akito914/myServoAmp_InverterBoard/InverterBoard.kicad_pcb

## KiCad design InverterBoard.kicad_pcb (2020-04-21)

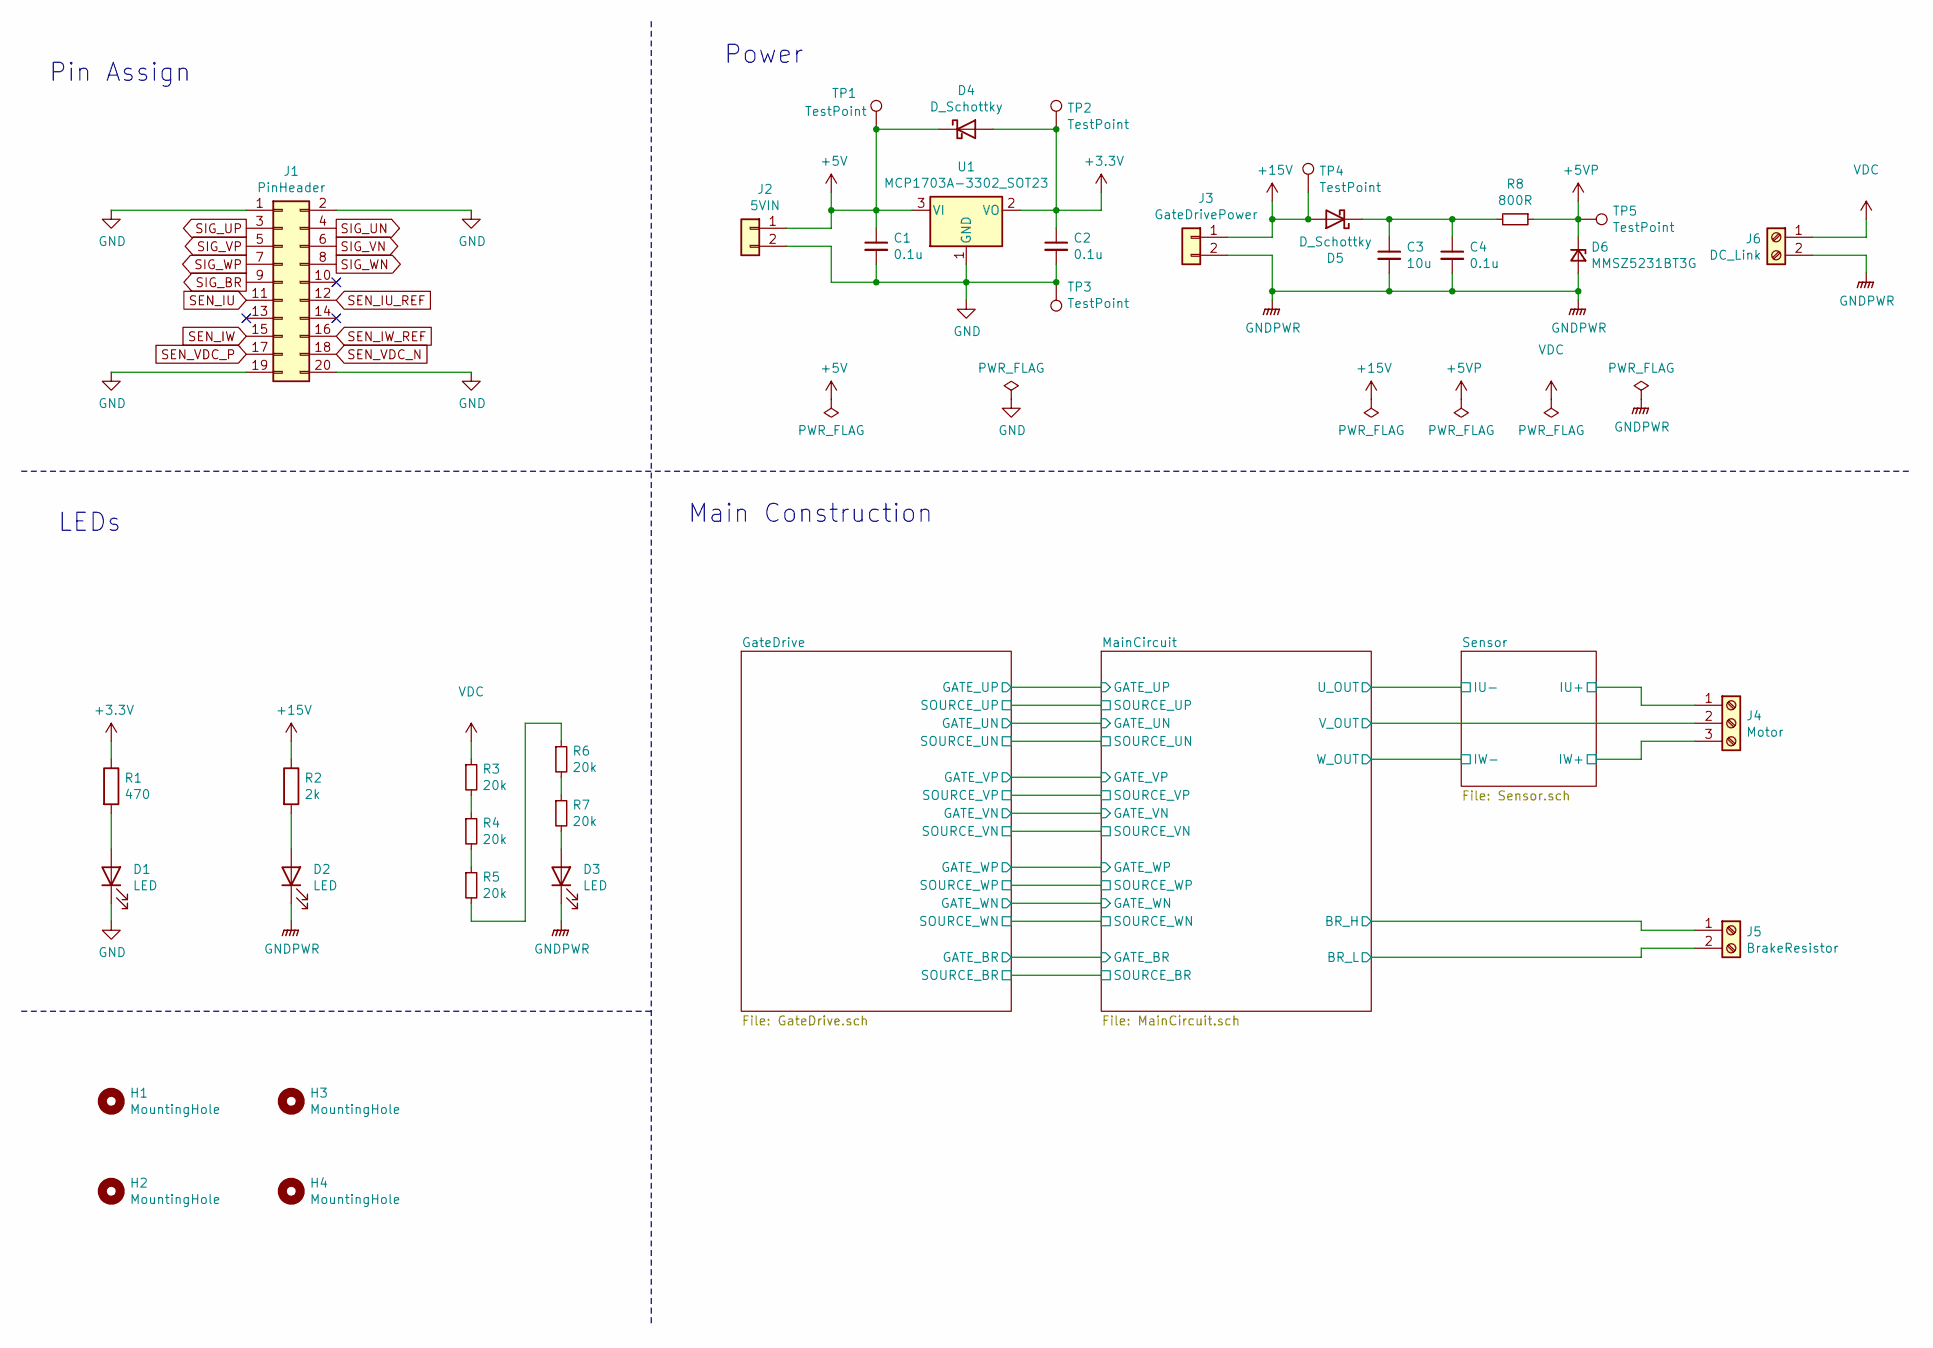
[picture p1: schematic InverterBoard.sch]

Parts:
C1, C2, C4: 0.1u; C_0603_1608Metric
C3: 10u; C_0805_2012Metric
D1, D2, D3: LED; LED_0603_1608Metric
D4, D5: D_Schottky; D_SOD-123
D6: MMSZ5231BT3G; D_SOD-123
H1, H2, H3, H4: MountingHole; MountingHole_3.2mm_M3
J1: PinHeader; IDC-Header_2x10_P2.54mm_Vertical
J2: 5VIN; JST_XH_S2B-XH-A-1_1x02_P2.50mm_Horizontal
J3: GateDrivePower; JST_XH_S2B-XH-A-1_1x02_P2.50mm_Horizontal
J4: Motor; JST_VH_B3PS-VH_1x03_P3.96mm_Horizontal
J5: BrakeResistor; JST_VH_B2PS-VH_1x02_P3.96mm_Horizontal
J6: DC_Link; JST_VH_B2PS-VH_1x02_P3.96mm_Horizontal
R1: 470; R_0603_1608Metric
R2: 2k; R_0603_1608Metric
R3, R4, R5, R6, R7: 20k; R_0603_1608Metric
R8: 800R; R_0603_1608Metric
TP1, TP2, TP3, TP4: TestPoint; TestPoint_Loop_D2.50mm_Drill1.0mm_LowProfile
TP5: TestPoint; TestPoint_Pad_D1.0mm
U1: MCP1703A-3302_SOT23; SOT-23

Connections:
+3V3: C2.1, D4.2 (A), R1.1, TP2.1, U1.2 (VO); also elsewhere on the board
+5V: C1.1, D4.1 (K), J2.1, TP1.1, U1.3 (VI)
+5VP: D6.1 (K), R8.1, TP5.1; also elsewhere on the board
+15V: D5.2 (A), J3.1, R2.1, TP4.1; also elsewhere on the board
/GateDrive/SOURCE_VP: J4.2; also elsewhere on the board
/MainCircuit/BR_L: J5.2; also elsewhere on the board
/Sensor/IU+: J4.1; also elsewhere on the board
/Sensor/IW+: J4.3; also elsewhere on the board
GND: C1.2, C2.2, D1.1 (K), J1.1, J1.2, J1.19, J1.20, J2.2, TP3.1, U1.1 (GND); also elsewhere on the board
GNDPWR: C3.2, C4.2, D2.1 (K), D3.1 (K), D6.2 (A), J3.2, J6.2; also elsewhere on the board
unnamed: C3.1, C4.1, D5.1 (K), R8.2
unnamed: D1.2 (A), R1.2
unnamed: D2.2 (A), R2.2
unnamed: D3.2 (A), R7.2
unnamed: R3.2, R4.1
unnamed: R4.2, R5.1
unnamed: R5.2, R6.1
unnamed: R6.2, R7.1
SEN_IU: J1.11; also elsewhere on the board
SEN_IU_REF: J1.12; also elsewhere on the board
SEN_IW: J1.15; also elsewhere on the board
SEN_IW_REF: J1.16; also elsewhere on the board
SEN_VDC_N: J1.18; also elsewhere on the board
SEN_VDC_P: J1.17; also elsewhere on the board
SIG_BR: J1.9; also elsewhere on the board
SIG_UN: J1.4; also elsewhere on the board
SIG_UP: J1.3; also elsewhere on the board
SIG_VN: J1.6; also elsewhere on the board
SIG_VP: J1.5; also elsewhere on the board
SIG_WN: J1.8; also elsewhere on the board
SIG_WP: J1.7; also elsewhere on the board
VDC: J5.1, J6.1, R3.1; also elsewhere on the board

Notes on the sheet:
Power
Main Construction
Pin Assign
LEDs

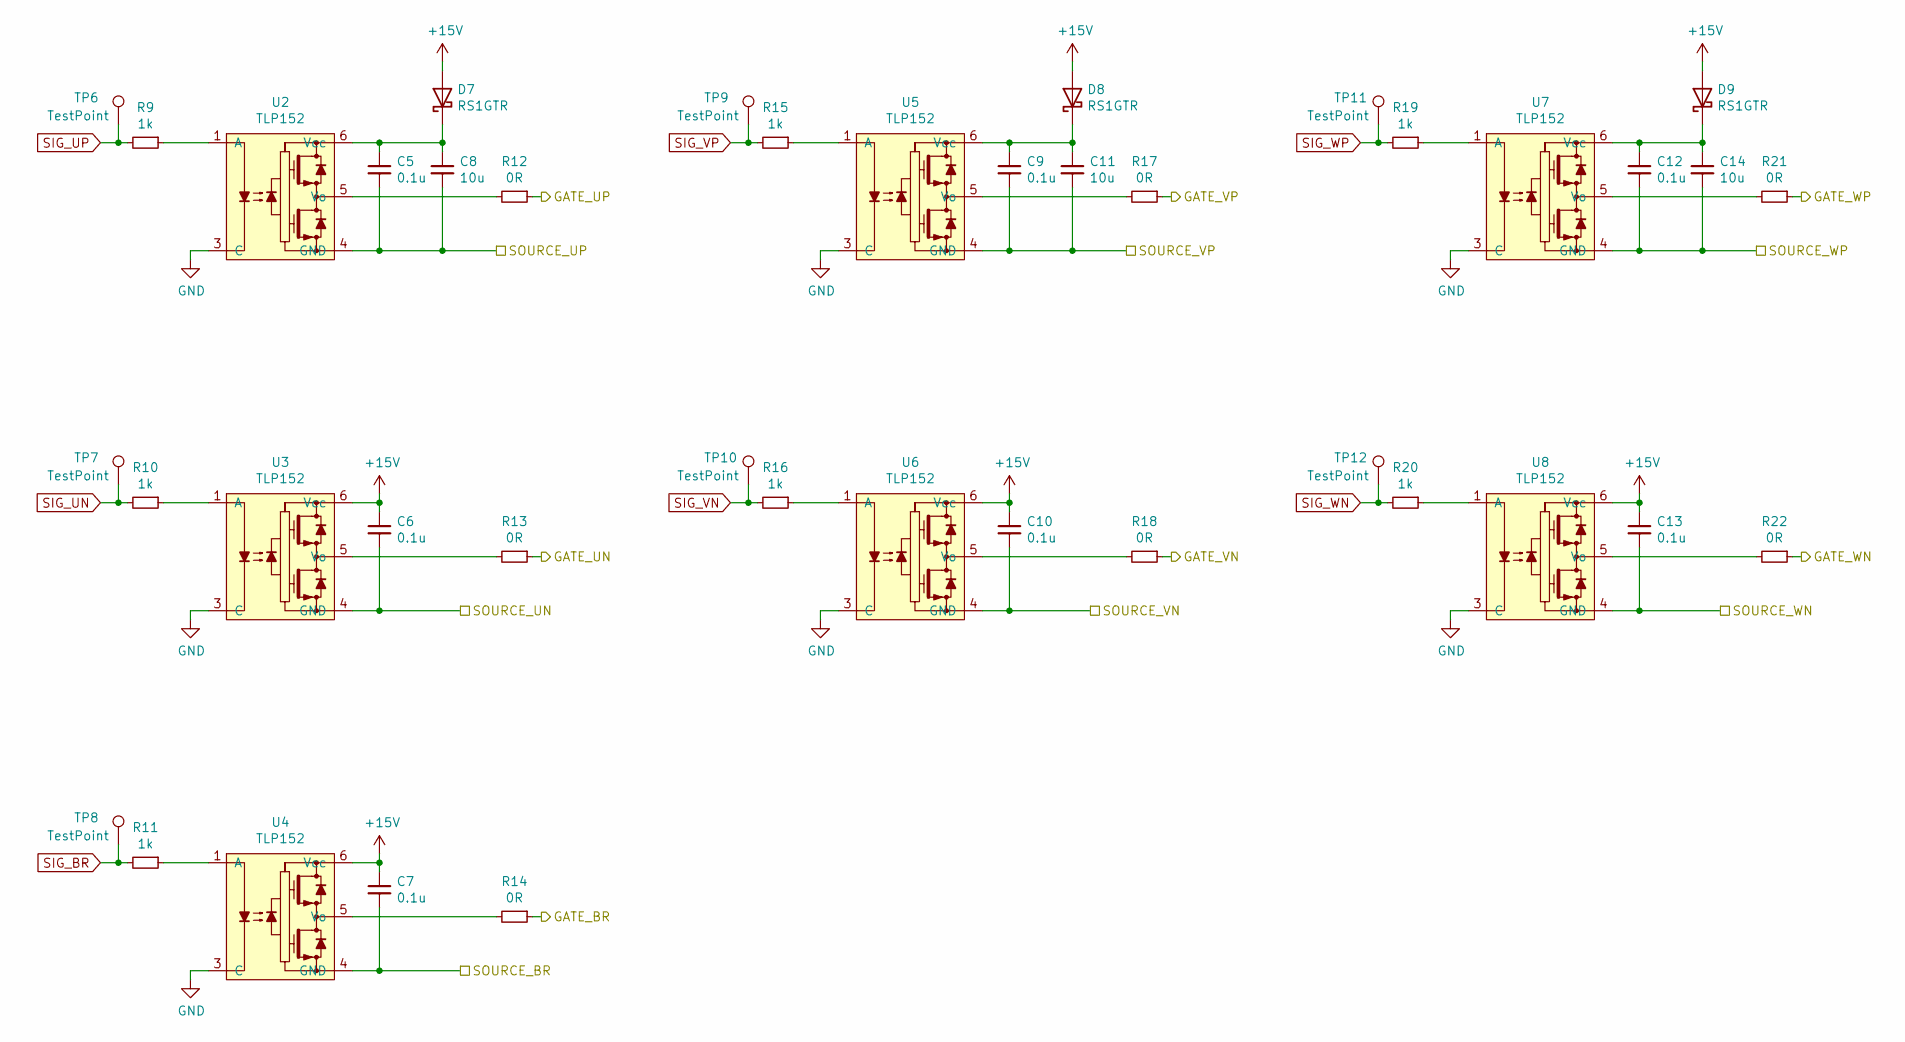
[picture p2: schematic GateDrive.sch]

Parts:
C5, C6, C7, C9, C10, C12, C13: 0.1u; C_0603_1608Metric
C8, C11, C14: 10u; C_0805_2012Metric
D7, D8, D9: RS1GTR; D_SMA
R9, R10, R11, R15, R16, R19, R20: 1k; R_0603_1608Metric
R12, R13, R14, R17, R18, R21, R22: 0R; R_0603_1608Metric
TP6, TP7, TP8, TP9, TP10, TP11, TP12: TestPoint; TestPoint_Pad_D1.0mm
U2, U3, U4, U5, U6, U7, U8: TLP152; SO-5_4.4x3.6mm_P1.27mm

Connections:
+15V: C6.1, C7.1, C10.1, C13.1, D7.2 (A), D8.2 (A), D9.2 (A), U3.6 (Vcc), U4.6 (Vcc), U6.6 (Vcc), U8.6 (Vcc); also elsewhere on the board
/GateDrive/GATE_BR: R14.1; also elsewhere on the board
/GateDrive/GATE_UN: R13.1; also elsewhere on the board
/GateDrive/GATE_UP: R12.1; also elsewhere on the board
/GateDrive/GATE_VN: R18.1; also elsewhere on the board
/GateDrive/GATE_VP: R17.1; also elsewhere on the board
/GateDrive/GATE_WN: R22.1; also elsewhere on the board
/GateDrive/GATE_WP: R21.1; also elsewhere on the board
/GateDrive/SOURCE_VP: C9.2, C11.2, U5.4 (GND); also elsewhere on the board
/Sensor/IU-: C5.2, C8.2, U2.4 (GND); also elsewhere on the board
/Sensor/IW-: C12.2, C14.2, U7.4 (GND); also elsewhere on the board
GND: U2.3 (C), U3.3 (C), U4.3 (C), U5.3 (C), U6.3 (C), U7.3 (C), U8.3 (C); also elsewhere on the board
GNDPWR: C6.2, C7.2, C10.2, C13.2, U3.4 (GND), U4.4 (GND), U6.4 (GND), U8.4 (GND); also elsewhere on the board
unnamed: C5.1, C8.1, D7.1 (K), U2.6 (Vcc)
unnamed: C9.1, C11.1, D8.1 (K), U5.6 (Vcc)
unnamed: C12.1, C14.1, D9.1 (K), U7.6 (Vcc)
unnamed: R9.1, U2.1 (A)
unnamed: R10.1, U3.1 (A)
unnamed: R11.1, U4.1 (A)
unnamed: R12.2, U2.5 (Vo)
unnamed: R13.2, U3.5 (Vo)
unnamed: R14.2, U4.5 (Vo)
unnamed: R15.1, U5.1 (A)
unnamed: R16.1, U6.1 (A)
unnamed: R17.2, U5.5 (Vo)
unnamed: R18.2, U6.5 (Vo)
unnamed: R19.1, U7.1 (A)
unnamed: R20.1, U8.1 (A)
unnamed: R21.2, U7.5 (Vo)
unnamed: R22.2, U8.5 (Vo)
SIG_BR: R11.2, TP8.1; also elsewhere on the board
SIG_UN: R10.2, TP7.1; also elsewhere on the board
SIG_UP: R9.2, TP6.1; also elsewhere on the board
SIG_VN: R16.2, TP10.1; also elsewhere on the board
SIG_VP: R15.2, TP9.1; also elsewhere on the board
SIG_WN: R20.2, TP12.1; also elsewhere on the board
SIG_WP: R19.2, TP11.1; also elsewhere on the board

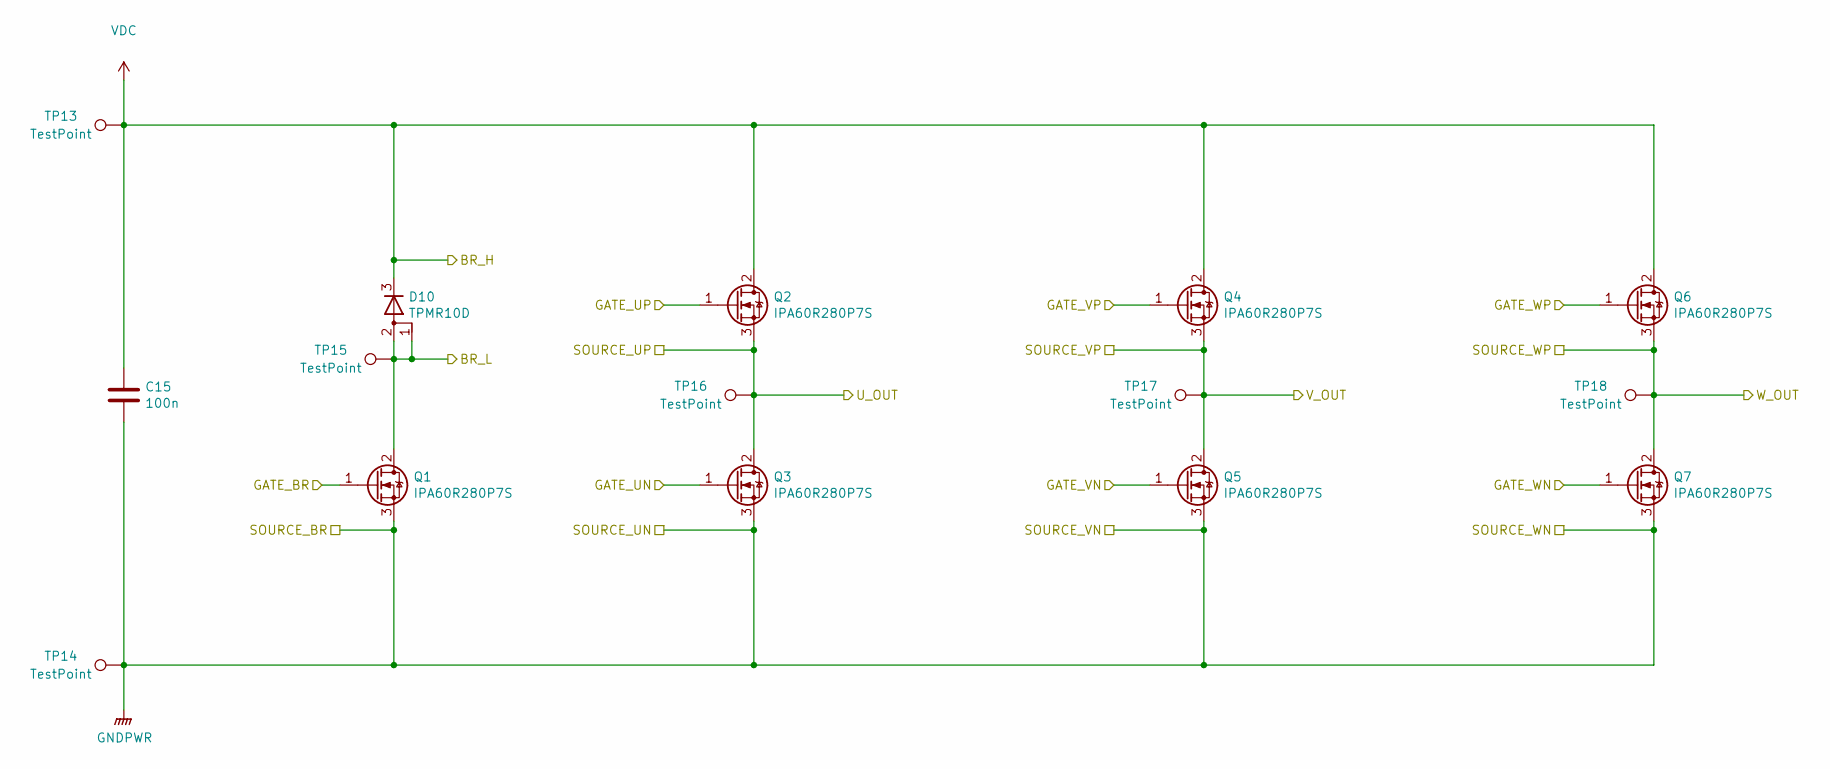
[picture p3: schematic MainCircuit.sch]

Parts:
C15: 100n; C_Rect_L13.0mm_W6.0mm_P10.00mm_FKS3_FKP3_MKS4
D10: TPMR10D; TO-277A
Q1, Q2, Q3, Q4, Q5, Q6, Q7: IPA60R280P7S; TO-220F-3_Horizontal_TabUp
TP13, TP14, TP15, TP16, TP17, TP18: TestPoint; TestPoint_Loop_D2.50mm_Drill1.0mm_LowProfile

Connections:
/GateDrive/GATE_BR: Q1.1 (G); also elsewhere on the board
/GateDrive/GATE_UN: Q3.1 (G); also elsewhere on the board
/GateDrive/GATE_UP: Q2.1 (G); also elsewhere on the board
/GateDrive/GATE_VN: Q5.1 (G); also elsewhere on the board
/GateDrive/GATE_VP: Q4.1 (G); also elsewhere on the board
/GateDrive/GATE_WN: Q7.1 (G); also elsewhere on the board
/GateDrive/GATE_WP: Q6.1 (G); also elsewhere on the board
/GateDrive/SOURCE_VP: Q4.3 (S), Q5.2 (D), TP17.1; also elsewhere on the board
/MainCircuit/BR_L: D10.1 (A), D10.2 (A), Q1.2 (D), TP15.1; also elsewhere on the board
/Sensor/IU-: Q2.3 (S), Q3.2 (D), TP16.1; also elsewhere on the board
/Sensor/IW-: Q6.3 (S), Q7.2 (D), TP18.1; also elsewhere on the board
GNDPWR: C15.2, Q1.3 (S), Q3.3 (S), Q5.3 (S), Q7.3 (S), TP14.1; also elsewhere on the board
VDC: C15.1, D10.3 (K), Q2.2 (D), Q4.2 (D), Q6.2 (D), TP13.1; also elsewhere on the board

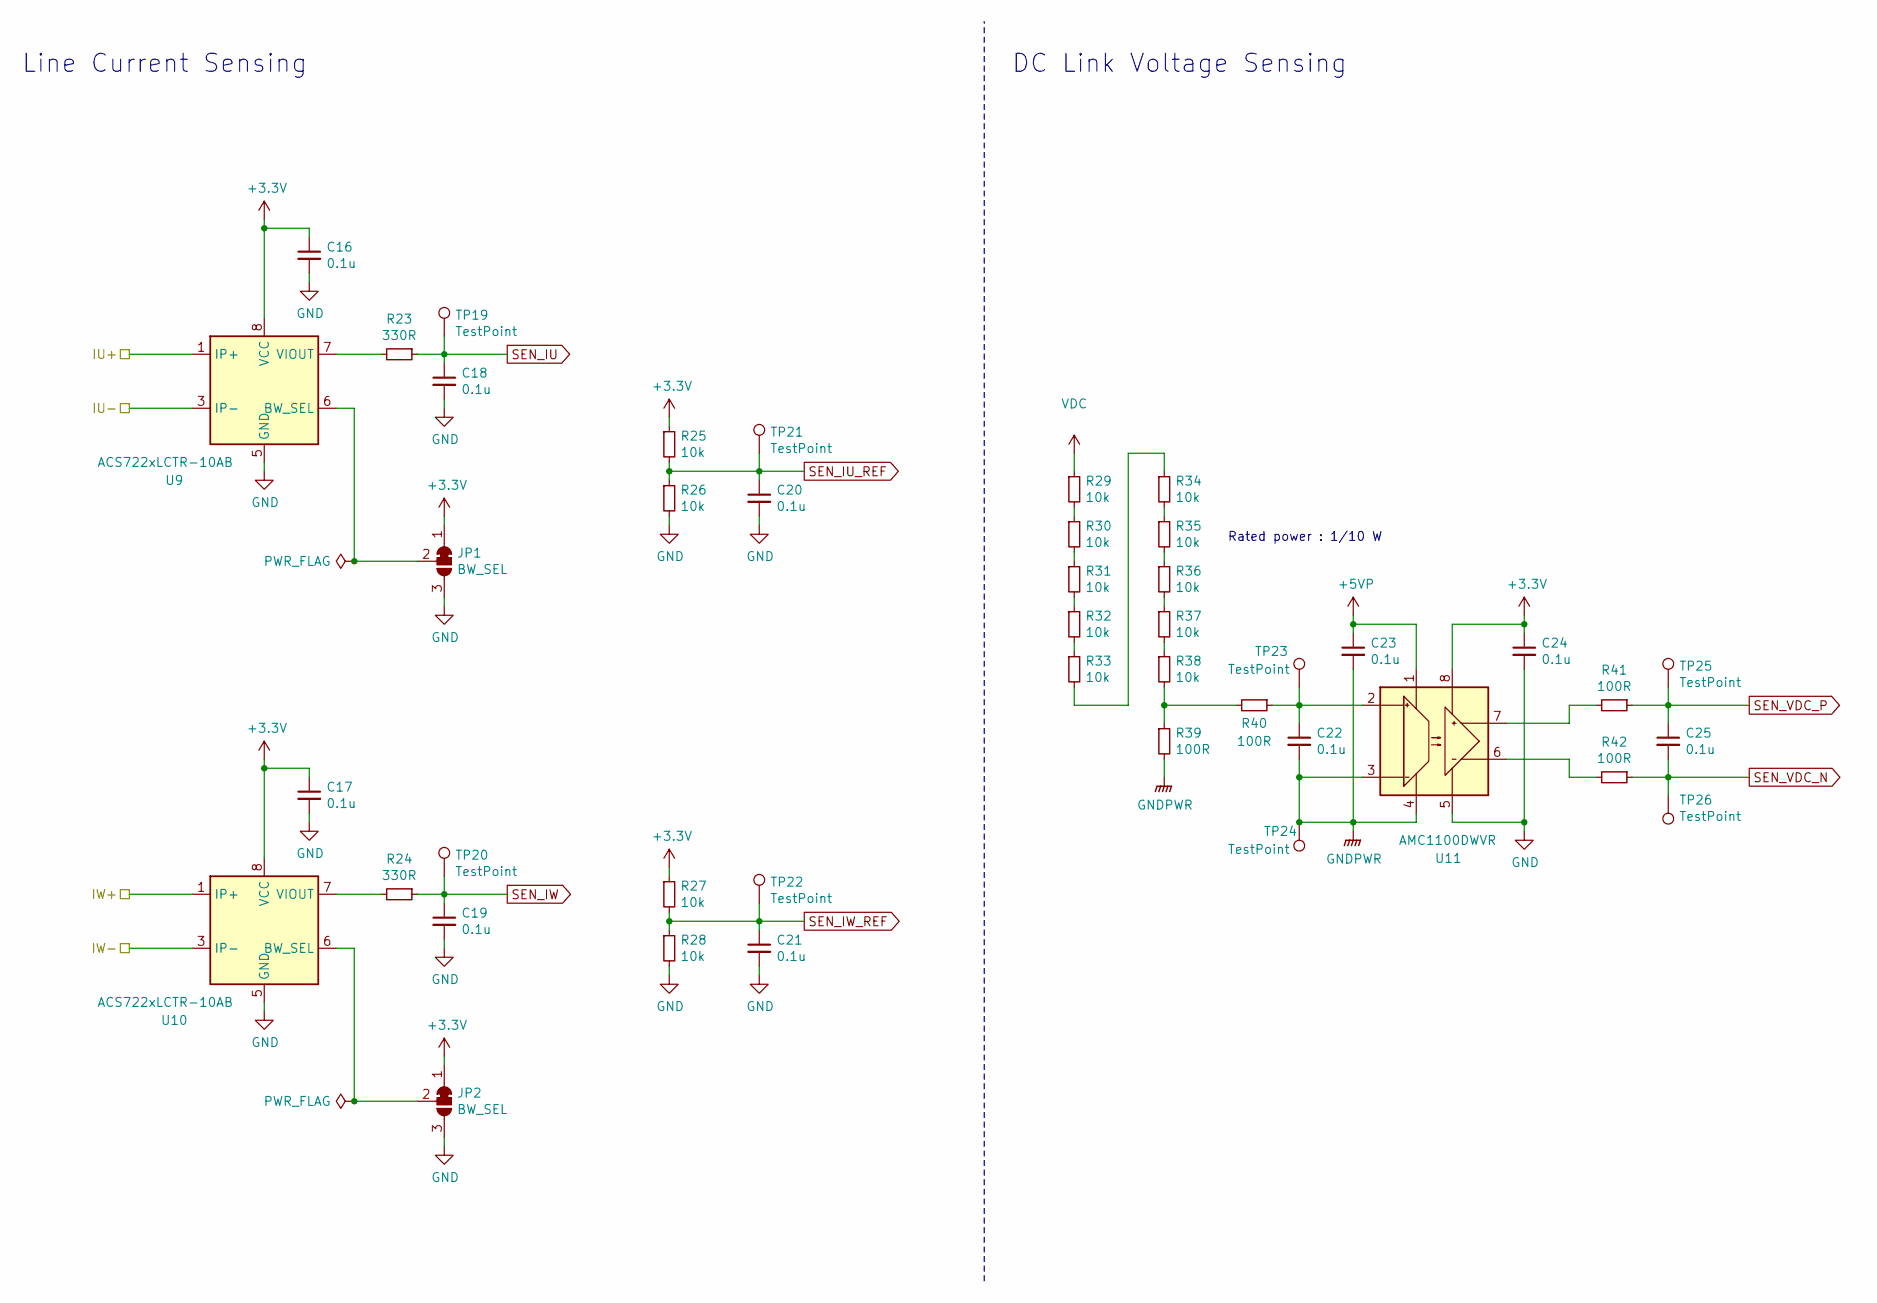
[picture p4: schematic Sensor.sch]

Parts:
C16, C17, C18, C19, C20, C21, C22, C23, C24, C25: 0.1u; C_0603_1608Metric
JP1, JP2: BW_SEL; SolderJumper-3_P1.3mm_Bridged12_RoundedPad1.0x1.5mm_NumberL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
R23, R24: 330R; R_0603_1608Metric
R25, R26, R27, R28, R29, R30, R31, R32, R33, R34, R35, R36, R37, R38: 10k; R_0603_1608Metric
R39, R40, R41, R42: 100R; R_0603_1608Metric
TP19, TP20, TP21, TP22, TP23, TP25, TP26: TestPoint; TestPoint_Pad_D1.0mm
TP24: TestPoint; TestPoint_Loop_D2.50mm_Drill1.0mm_LowProfile
U9, U10: ACS722xLCTR-10AB; SOIC-8_3.9x4.9mm_P1.27mm
U11: AMC1100DWVR; SOIC-8_7.5x5.85mm_P1.27mm

Connections:
+3V3: C16.1, C17.1, C24.1, JP1.1 (A), JP2.1 (A), R25.1, R27.1, U9.8 (VCC), U10.8 (VCC), U11.8 (VDD2); also elsewhere on the board
+5VP: C23.1, U11.1 (VDD1); also elsewhere on the board
/Sensor/IU+: U9.1 (IP+), U9.2 (IP+); also elsewhere on the board
/Sensor/IU-: U9.3 (IP-), U9.4 (IP-); also elsewhere on the board
/Sensor/IW+: U10.1 (IP+), U10.2 (IP+); also elsewhere on the board
/Sensor/IW-: U10.3 (IP-), U10.4 (IP-); also elsewhere on the board
GND: C16.2, C17.2, C18.2, C19.2, C20.2, C21.2, C24.2, JP1.3 (B), JP2.3 (B), R26.2, R28.2, U9.5 (GND), U10.5 (GND), U11.5 (GND2); also elsewhere on the board
GNDPWR: C22.2, C23.2, R39.2, TP24.1, U11.3 (IN-), U11.4 (GND1); also elsewhere on the board
unnamed: C22.1, R40.1, TP23.1, U11.2 (IN+)
unnamed: JP1.2 (C), U9.6 (BW_SEL)
unnamed: JP2.2 (C), U10.6 (BW_SEL)
unnamed: R23.2, U9.7 (VIOUT)
unnamed: R24.2, U10.7 (VIOUT)
unnamed: R29.2, R30.1
unnamed: R30.2, R31.1
unnamed: R31.2, R32.1
unnamed: R32.2, R33.1
unnamed: R33.2, R34.1
unnamed: R34.2, R35.1
unnamed: R35.2, R36.1
unnamed: R36.2, R37.1
unnamed: R37.2, R38.1
unnamed: R38.2, R39.1, R40.2
unnamed: R41.2, U11.7 (OUT+)
unnamed: R42.2, U11.6 (OUT-)
SEN_IU: C18.1, R23.1, TP19.1; also elsewhere on the board
SEN_IU_REF: C20.1, R25.2, R26.1, TP21.1; also elsewhere on the board
SEN_IW: C19.1, R24.1, TP20.1; also elsewhere on the board
SEN_IW_REF: C21.1, R27.2, R28.1, TP22.1; also elsewhere on the board
SEN_VDC_N: C25.2, R42.1, TP26.1; also elsewhere on the board
SEN_VDC_P: C25.1, R41.1, TP25.1; also elsewhere on the board
VDC: R29.1; also elsewhere on the board

Notes on the sheet:
Rated power : 1/10 W
DC Link Voltage Sensing
Line Current Sensing

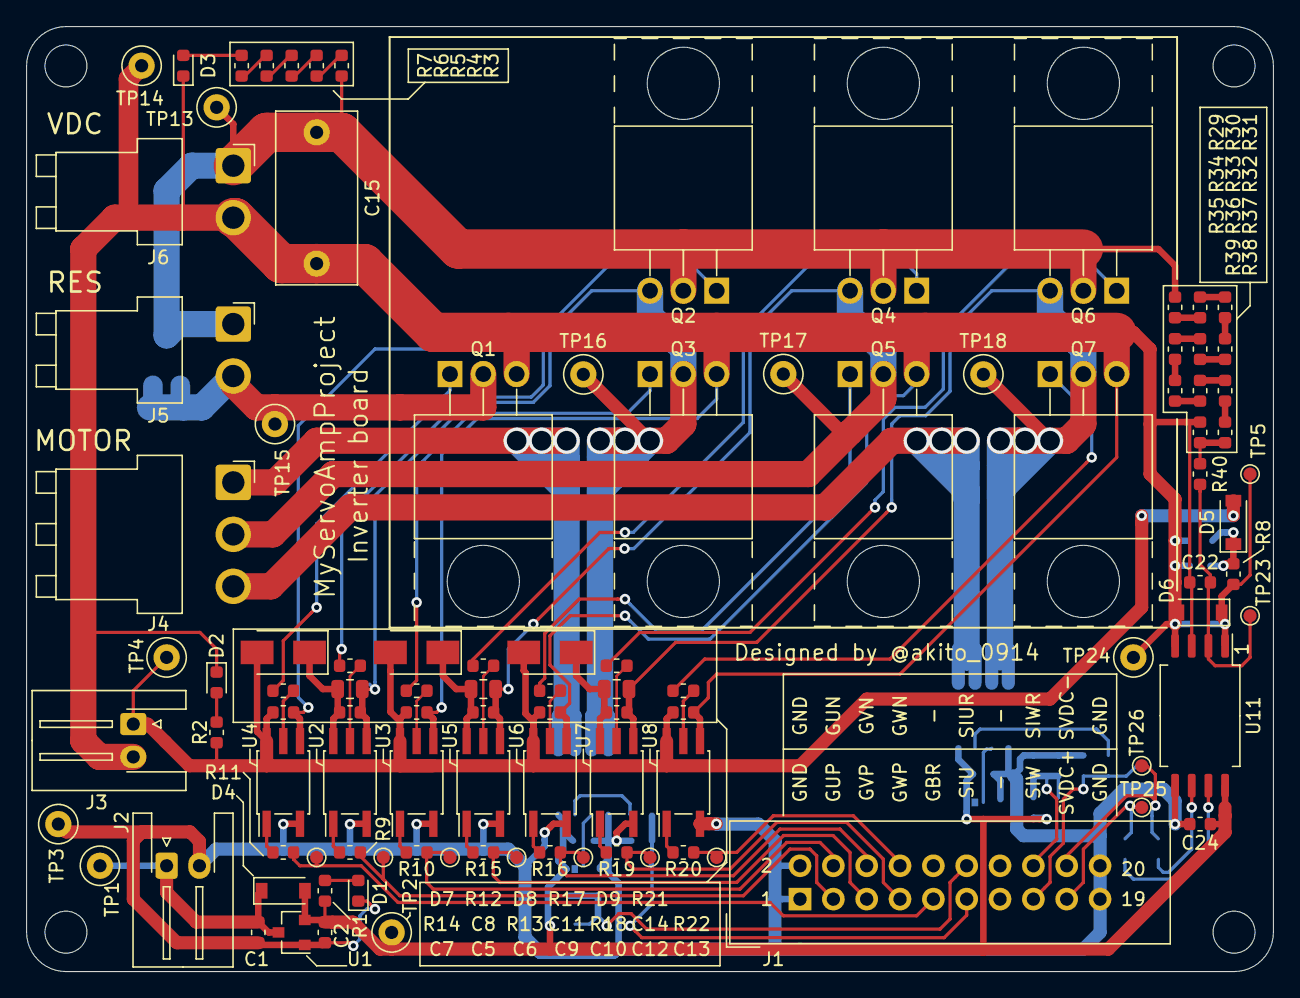
[picture p5: board InverterBoard.kicad_pcb from above]

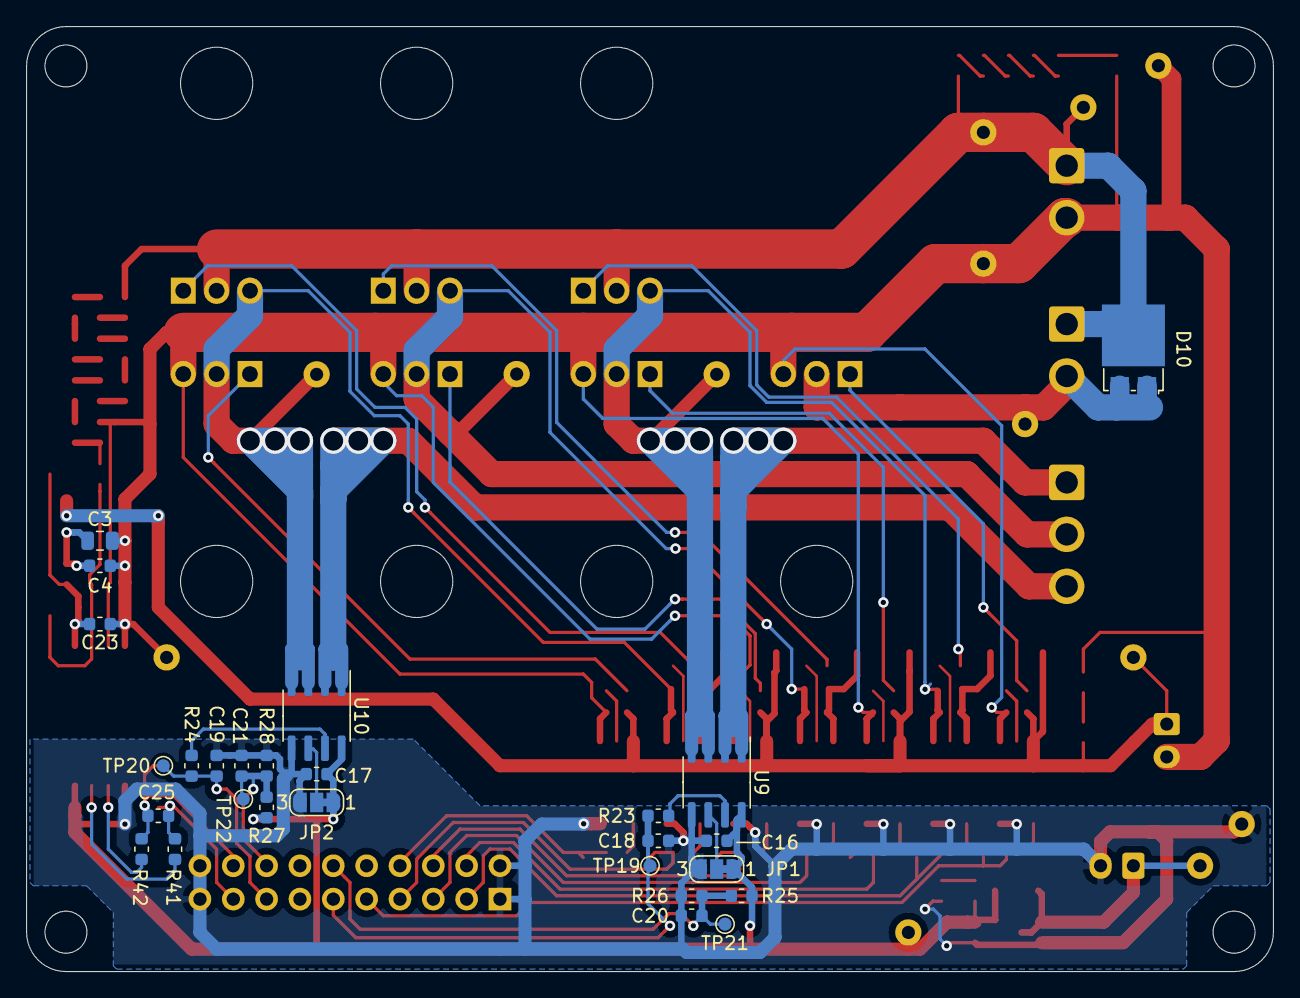
[picture p6: board InverterBoard.kicad_pcb from below]

Board: 2 copper layers, 95.0 x 72.0 mm, 133 parts (27 on the bottom side), 75 nets.
