akito914/myServoAmp_InverterBoard/(commit log)

2020-04-05 回路図完成、アートワーク主回路まで
    [GateDrive.sch, InverterBoard.kicad_pcb, InverterBoard.sch, MainCircuit.sch, Sensor.sch]
2020-04-07 アートワークも一応完成
    [InverterBoard.kicad_pcb]
2020-04-07 TODO削除
    [InverterBoard.kicad_pcb]
2020-04-10 テストポイント追加，シルク調整，固定穴マスク追加
    [GateDrive.sch, InverterBoard.kicad_pcb, InverterBoard.sch, MainCircuit.sch, Sensor.sch]
2020-04-11 GNDベタ追加，電流センサ周辺部品の配置調整
    [InverterBoard.kicad_pcb]
2020-04-11 DCリンクのフィルムキャパシタの値修正
    [MainCircuit.sch]
2020-04-16 配線ちょっと修正
    [InverterBoard.kicad_pcb]
2020-04-21 ガーバー吐き出し
    [InverterBoard-B_Cu.gbl, InverterBoard-B_Mask.gbs, InverterBoard-B_Paste.gbp, InverterBoard-B_SilkS.gbo, InverterBoard-Edge_Cuts.gm1, InverterBoard-F_Cu.gtl, InverterBoard-F_Mask.gts, InverterBoard-F_Paste.gtp]
2020-04-21 Elecrow発注用ガーバー
    [InverterBoard.GBL, InverterBoard.GBO, InverterBoard.GBS, InverterBoard.GTL, InverterBoard.GTO, InverterBoard.GTS]
